javnson/GMP_SPM_Module/hw/PowerSupplyModule_DCSolution.pdf

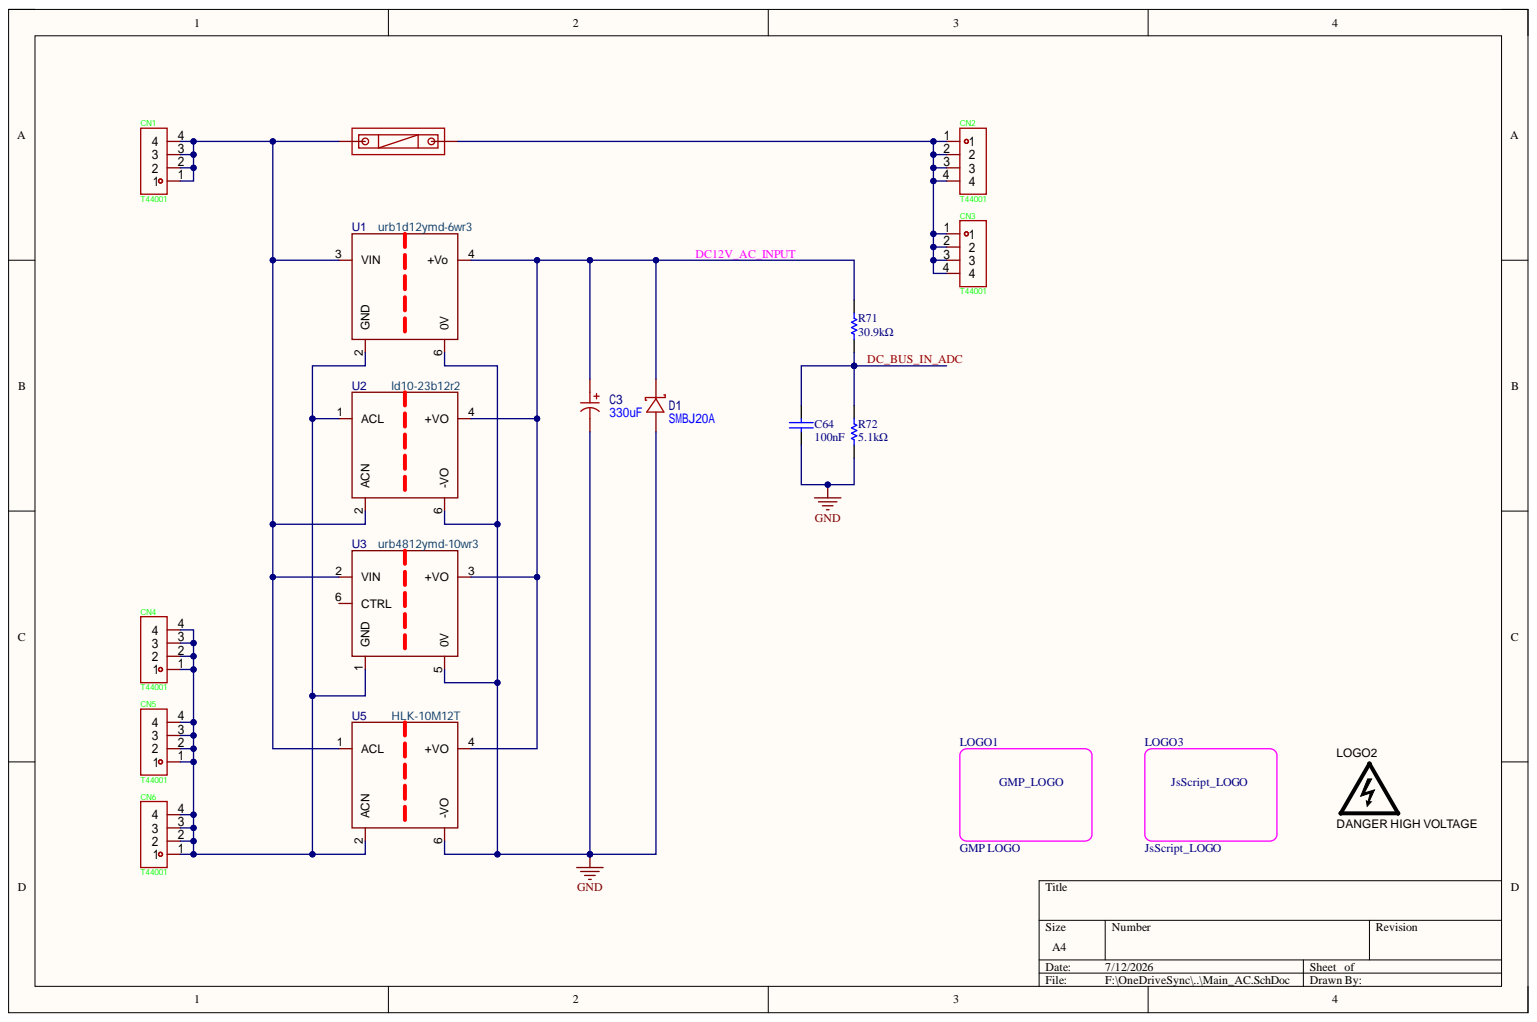
[picture p1: page 1]

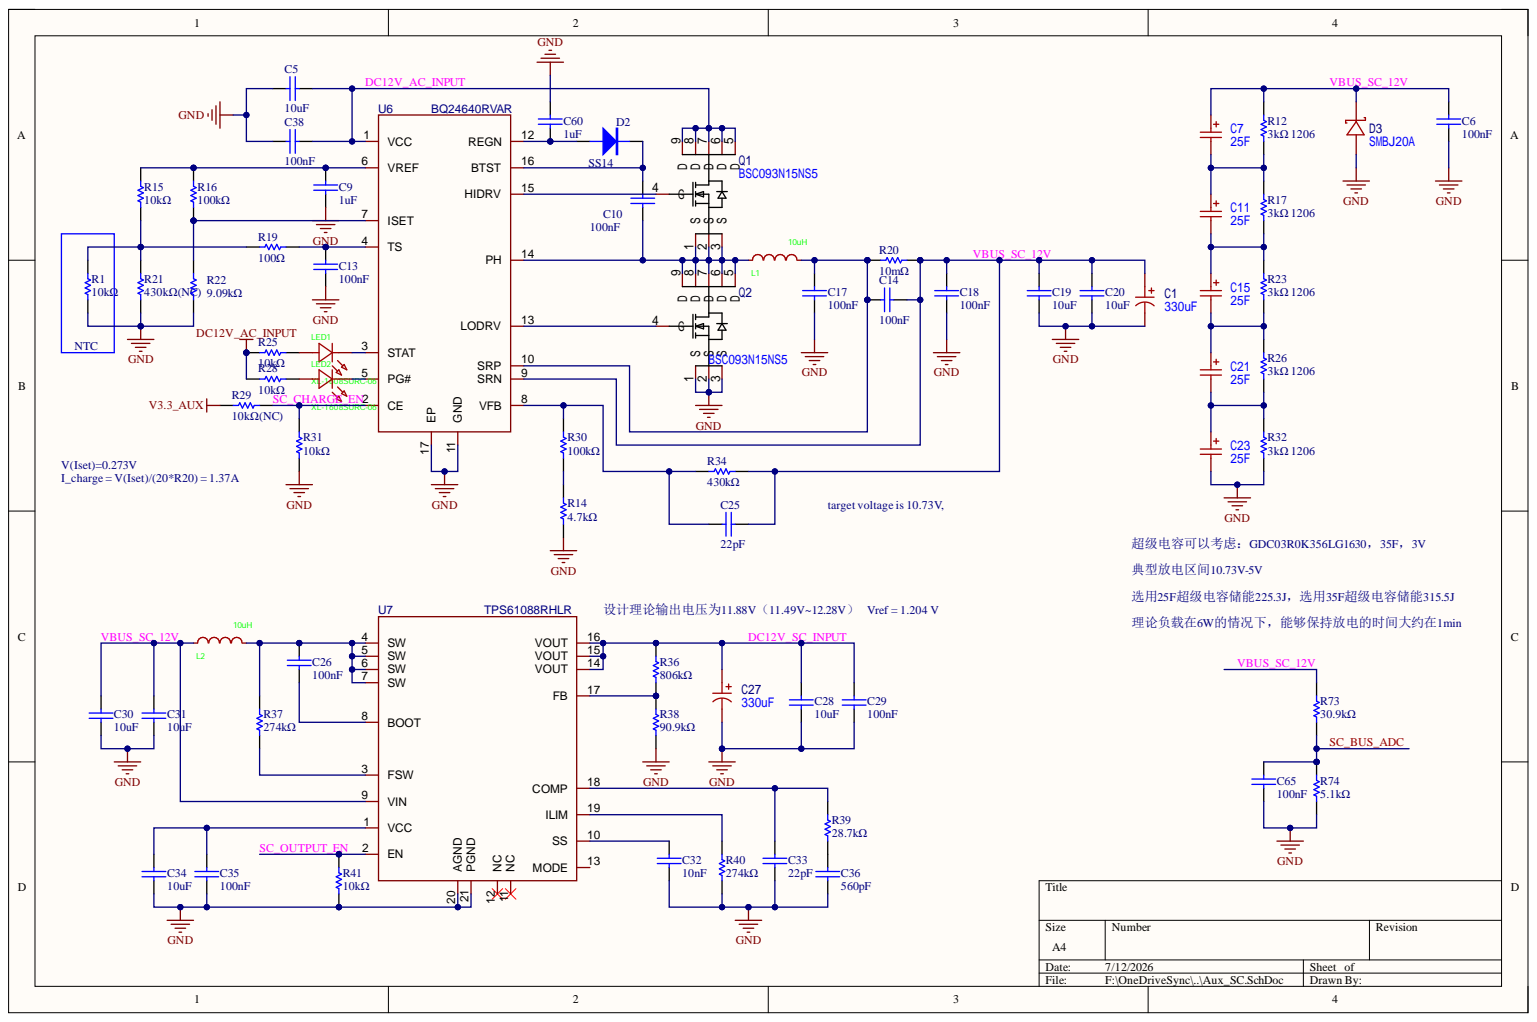
[picture p2: page 2]

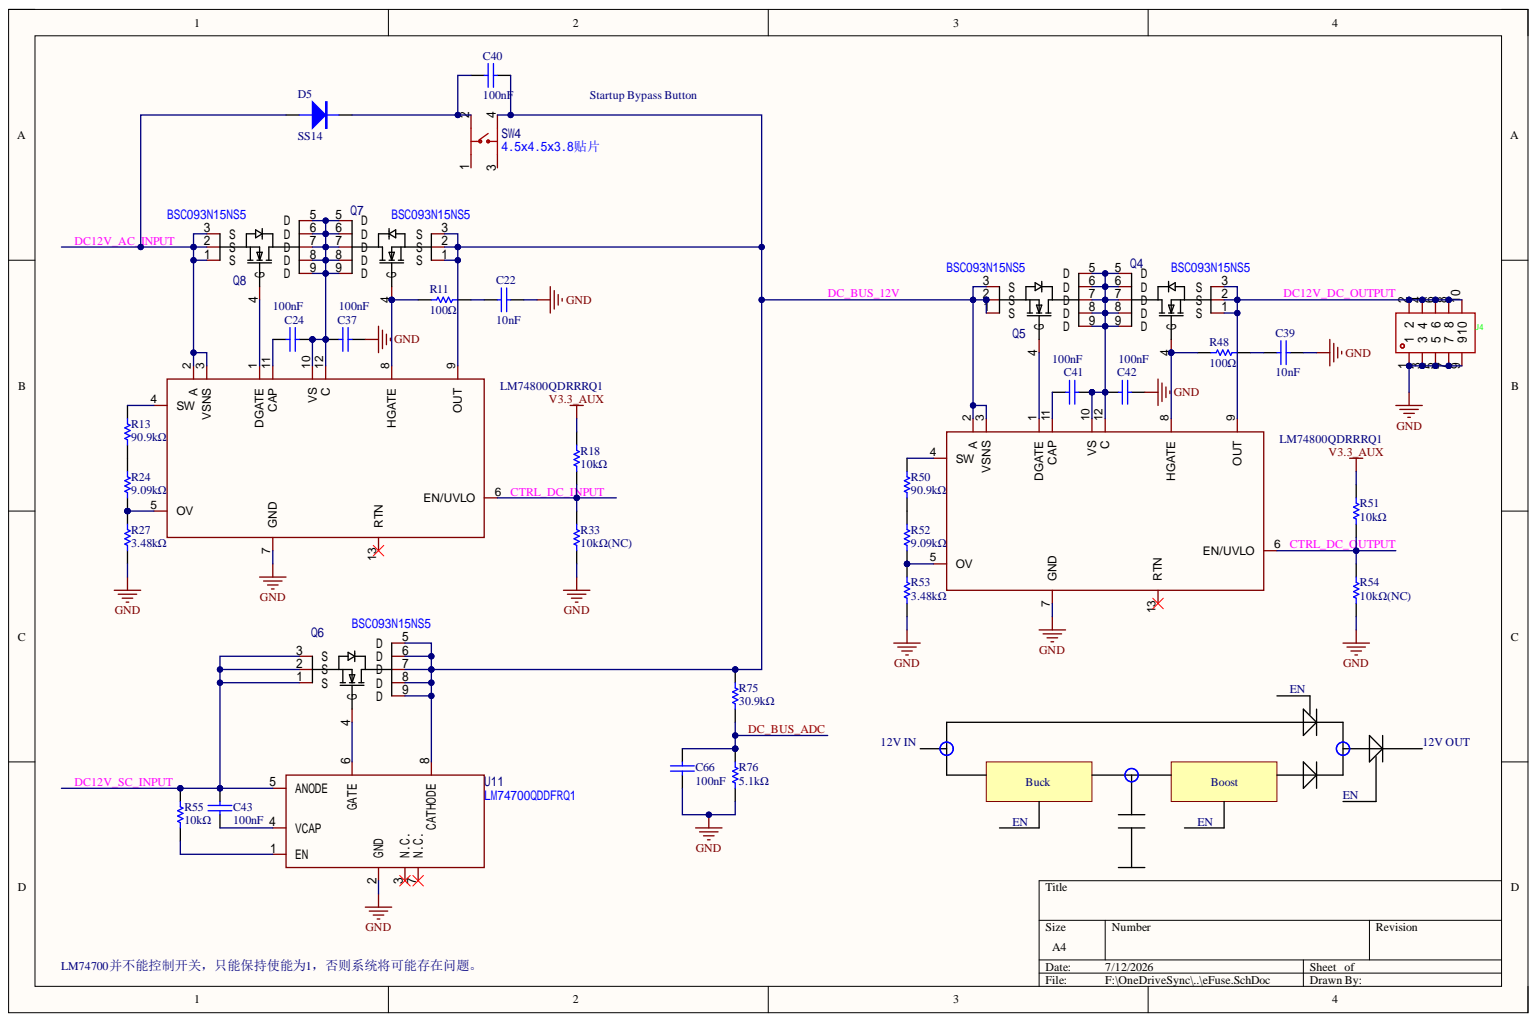
[picture p3: page 3]

GND | | Q5 | 100nF C41 | 100nF

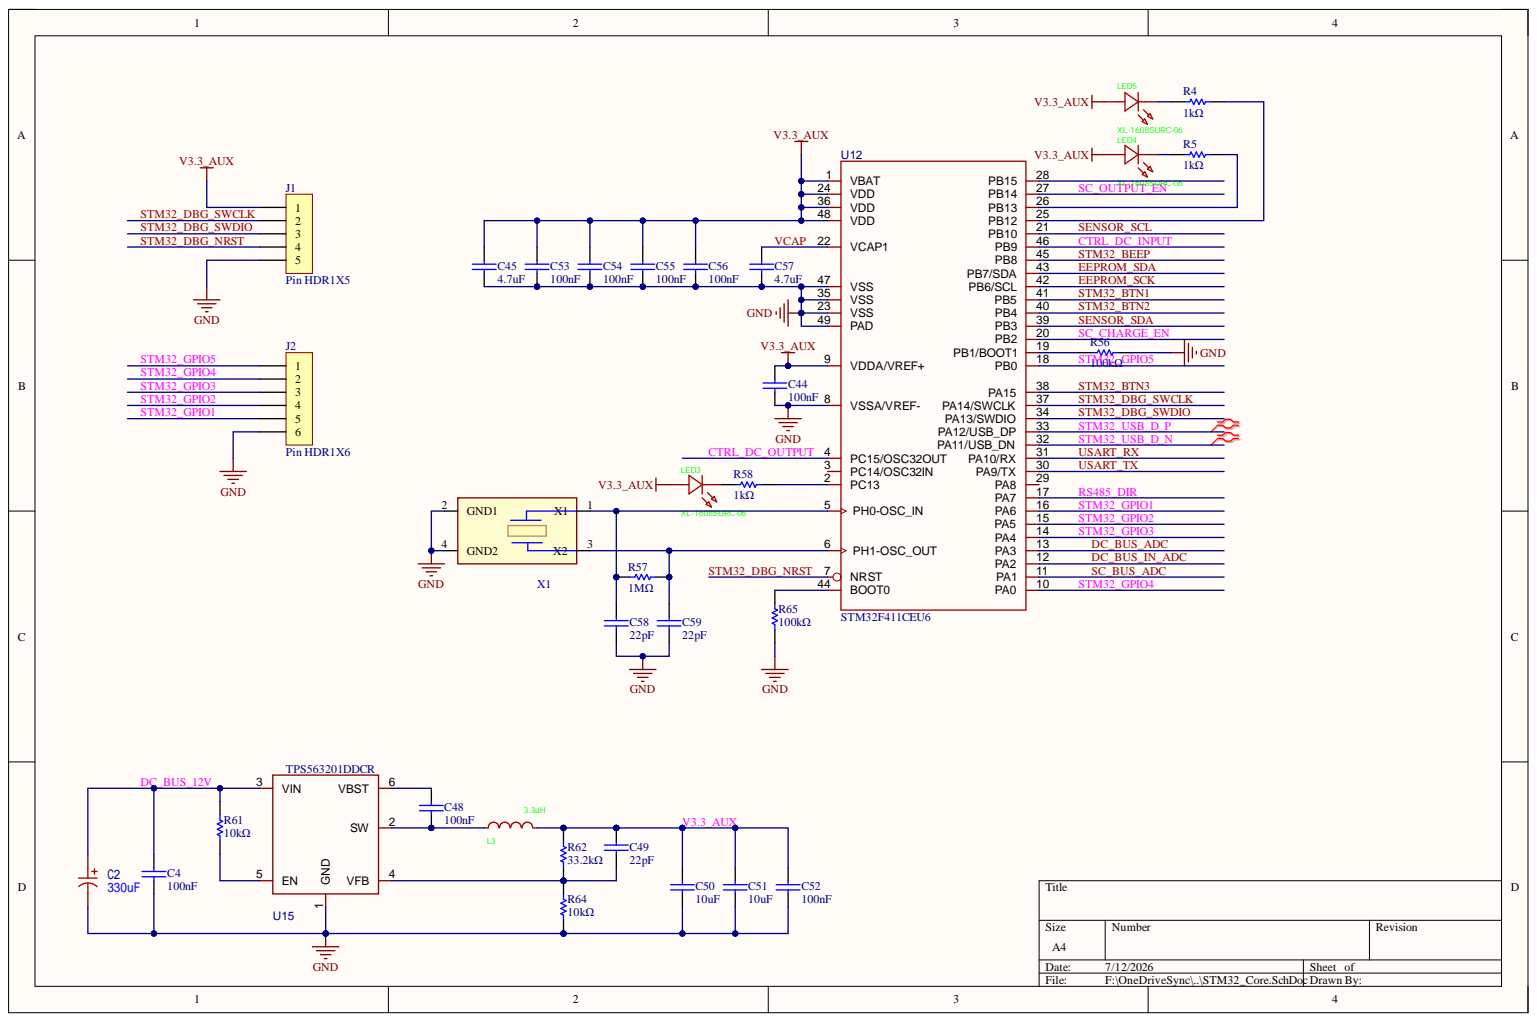
[picture p4: page 4]

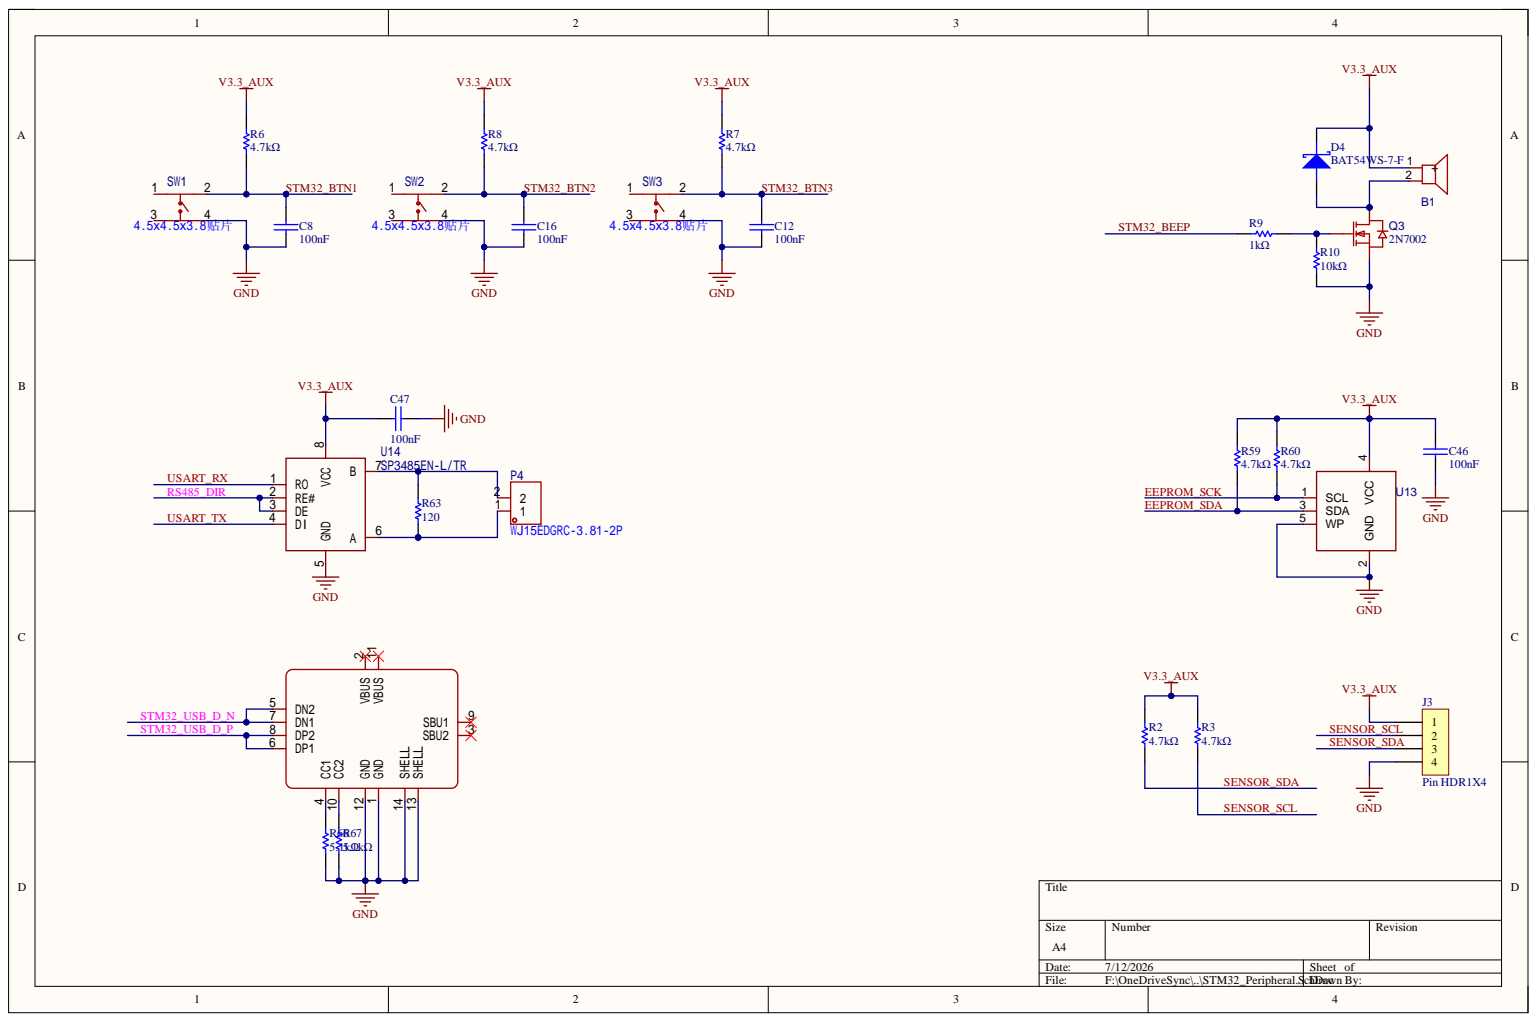
[picture p5: page 5]

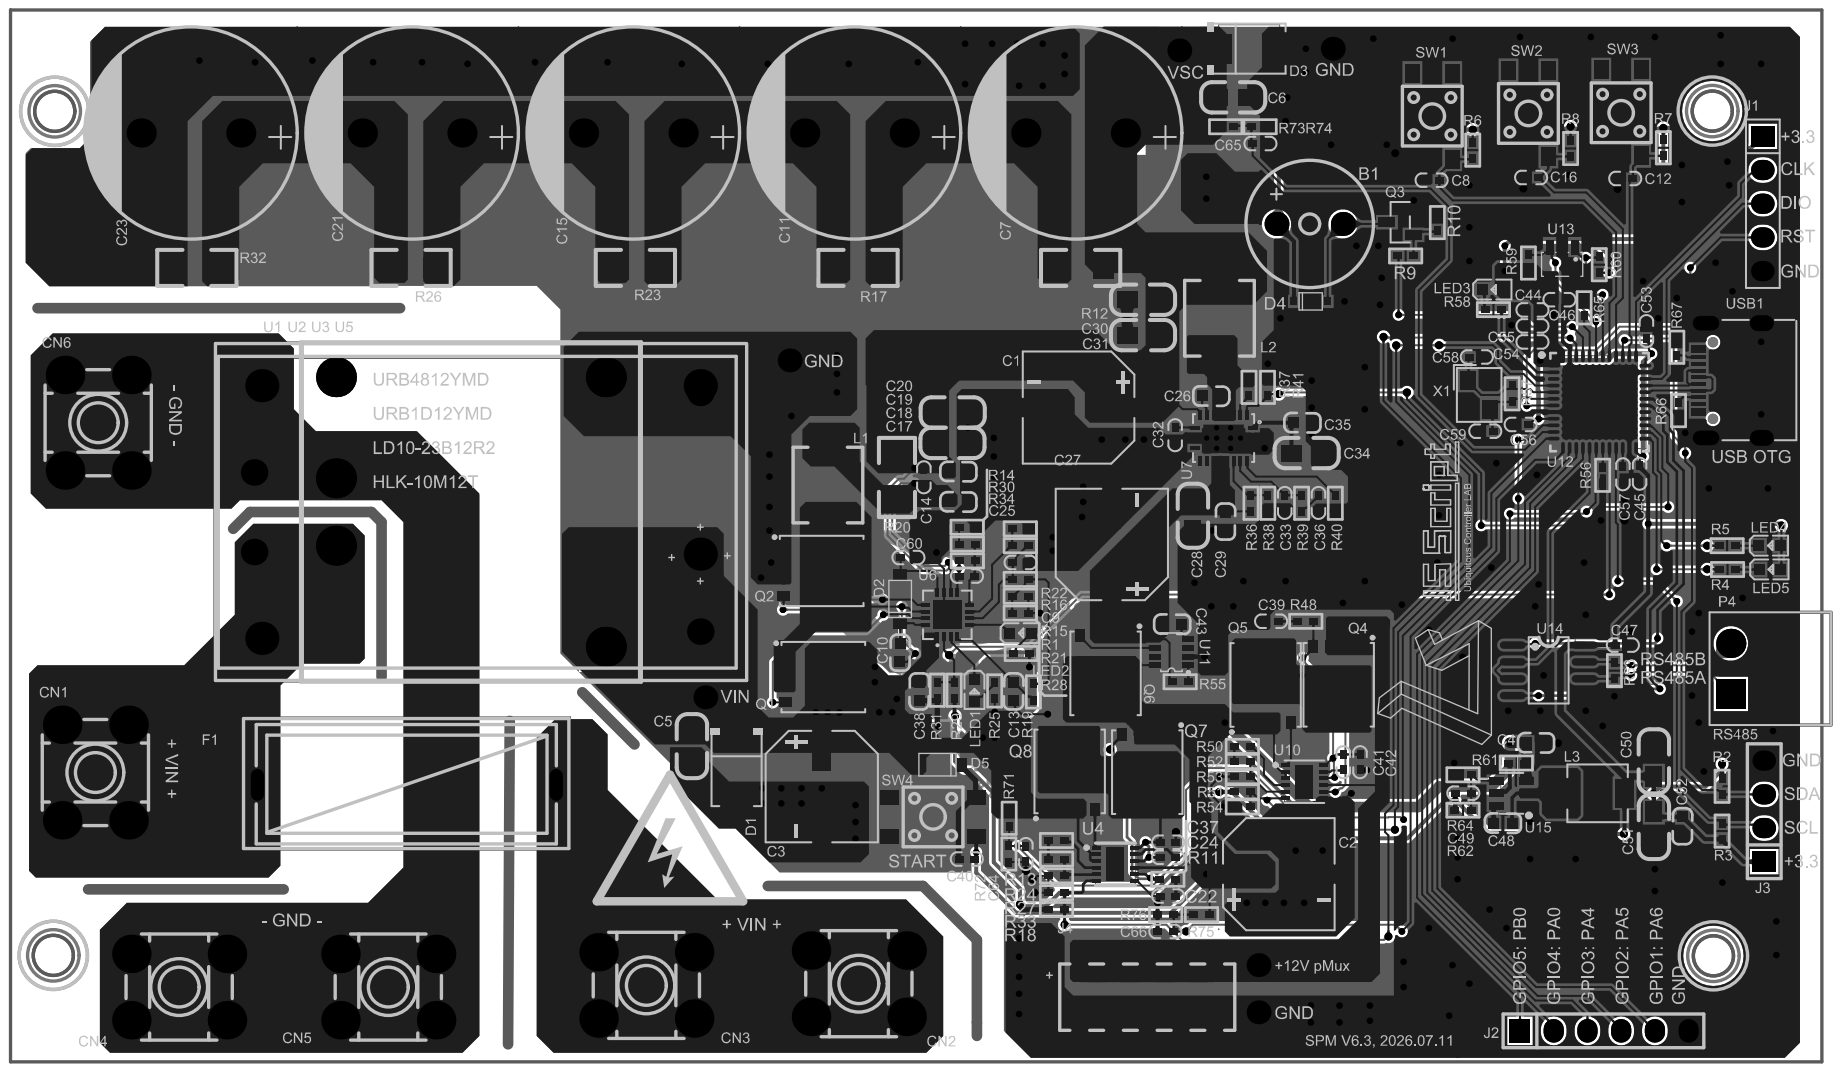
[picture p6: page 6]

Comment | Description | Designator | Footprint | LibRef | Quantity
HNB09A05 | Buzzer | B1 | BUZ-TH_BD9.6-
P5.00-D0.7-FD | HNB09A05 | 1
330uF | C970701 | C1, C2, C3, C27 | CAP-SMD_BD8.0-L8.3-W8.3-FD | RVT1E331M0810 330UF 25V | 4
100nF | 无极性电容 | C4, C10, C13, C17, C18, C26, C29, C35, C38, C43, C48, C52 | 0603C | CAP | 12
10uF | 无极性电容 | C5, C19, C20, C28, C30, C31, C34, C50, C51 | 0805C | CAP | 9
100nF | 无极性电容 | C6 | 0805C | CAP | 1
25F | BCT2R7M256YS162 5A2NP01 | C7, C11, C15, C21, C23 | CAP-TH_BD16.0-P7.50-D1.2-FD | ERF1VM222L25OT | 5
100nF | 无极性电容 | C8, C12, C14, C16, C24, C37, C40, C41, C42, C44, C46, C47, C53, C54, C55, C56, C64, C65, C66 | 0402C | CAP | 19
1uF | 无极性电容 | C9, C60 | 0402C | CAP | 2
10nF | 无极性电容 | C22, C32, C39 | 0402C | CAP | 3
22pF | 无极性电容 | C25, C33, C49, C58, C59 | 0402C | CAP | 5
560pF | 无极性电容 | C36 | 0402C | CAP | 1
4.7uF | 无极性电容 | C45, C57 | 0402C | CAP | 2
T44001 | | CN1, CN2, CN3, CN4, CN5, CN6 | CONN-TH_T44001 | T44001(PCB端子) | 6
SMBJ20A | C151257, [NoValue] | D1, D3 | SMB_L4.6-W3.6-LS5.3-RD | SMBJ20A_C151257 | 2
SS14 | 普通二极管 | D2, D5 | SOD-123 | DIODE | 2
BAT54WS-7-F | 肖特基二极管 | D4 | SOD-323 | DIODE SCHOTTKY | 1
保险丝透明座 | 保险丝座类型:支座 型;通道数:1;保险丝 类型:圆柱; | F1 | FUSE-TH_L24.5-W9.8-P22.5 | 保险丝透明座 | 1
Pin HDR1X5 | | J1 | Pin HDR1X5/2.54mm-S | Pin HDR1X5 | 1
Pin HDR1X6 | | J2 | Pin HDR1X6/2.54mm-S | Pin HDR1X6 | 1
Pin HDR1X4 | | J3 | Pin HDR1X4/2.54mm-S | Pin HDR1X4 | 1
PZ254-2-05-S | HDR-2.54-2*5P | J4 | HDR-SMD_10P-P2.54-V-M-R2-C5-LS7.5 | PZ254-2-05-S | 1
10uH | L | L1, L2 | IND-SMD_L5.7-W5.2_SMPI0520 | FXL0630-3R3-M | 2
3.3uH | L | L3 | IND-SMD_L4.4-W4.2 | FXL0630-3R3-M | 1
XL-1608SURC-06 | LED 0603 | LED1, LED2, LED3, LED4, LED5 | LED0603-RD_RED | XL-1608SURC-06 | 5
GMP LOGO | LOGO GMP Main. | LOGO1 | GMP LOGO | GMP_LOGO | 1
JsScript_LOGO | LOGO JsScript | LOGO3 | JsScript-R-V2-test-update | JsScript_LOGO | 1
WJ15EDGRC-3.81-2P | C8387 | P4 | CONN-TH_2P-P3.81_WJ15EDGRC-3.81-2P | WJ15EDGRC-3.81-2P | 1
BSC093N15NS5 | MOSFET Infineon 150V, 87A, 9.3mΩ @10V, 44A | Q1, Q2, Q4, Q5, Q6, Q7, Q8 | PG-TDSON-8_L5.0-W6.0-P1.27-LS6.2-BL-EP | BSC093N15NS5 | 7
2N7002 | MOSFET | Q3 | SOT-23-3_L2.9-W1.3-P1.90-LS2.4-BR | 2N7002 | 1
10kΩ | | R1, R10, R15, R18, R25, R28, R31, R41, R51, R55, R61, R64 | 0402R | RES | 12
4.7kΩ | | R2, R3, R6, R7, R8, R14, R59, R60 | 0402R | RES | 8
1kΩ | | R4, R5, R9, R58 | 0402R | RES | 4
100Ω | | R11, R19, R48 | 0402R | RES | 3
3kΩ 1206 | | R12, R17, R23, R26, R32 | 1206R | RES | 5
90.9kΩ | | R13, R38, R50 | 0402R | RES | 3
100kΩ | | R16, R30, R56, R65 | 0402R | RES | 4
10mΩ | | R20 | 1206R | RES | 1
430kΩ(NC) | | R21 | 0402R | RES | 1
9.09kΩ | | R22, R24, R52 | 0402R | RES | 3
3.48kΩ | | R27, R53 | 0402R | RES | 2
10kΩ(NC) | | R29, R33, R54 | 0402R | RES | 3
430kΩ | | R34 | 0402R | RES | 1
806kΩ | | R36 | 0402R | RES | 1
274kΩ | | R37, R40 | 0402R | RES | 2
28.7kΩ | | R39 | 0402R | RES | 1
1MΩ | | R57 | 0402R | RES | 1
33.2kΩ | | R62 | 0402R | RES | 1
120 | | R63 | 0402R | RES | 1
5.1kΩ | | R66, R67, R72, R74, R76 | 0402R | RES | 5
30.9kΩ | | R71, R73, R75 | 0402R | RES | 3
4.5x4.5x3.8贴片 | | SW1, SW2, SW3, SW4 | SW-SMD_4P-L4.5-W4.5-P3.00-LS6.8 | 4.5x4.5x3.8贴片 | 4
urb1d12ymd-6wr3 | 是隔离 6W DC-DC 转换器产品，输入 电压 40-160VDC， 效率高达 86%，输入 到输出隔离测试电 压为 2250VDC，可 在-40℃ 至 + 85℃ 的环境温度下安全 运行，具备输入欠 压保护、输出短路 、过流、过压保护 功能。 | U1 | PWRM-TH_URB1DXXYMD-6WR3 | urb1d12ymd-6wr3 | 1
ld10-23b12r2 | 超宽输入电压范 围，交直流两用， 低功耗，低纹波噪 声，高效率，高可 靠性，安全隔离。 广泛应用于工业、 电力、家电、仪表 、通讯及民用等行 业。 | U2 | PWRM-TH_LD10-23BXXR2 | ld10-23b12r2 | 1
urb4812ymd-10wr3 | URB4812YMD-10WR3系列产品输 出功率为10W,4:1超 宽电压输入范围， 效率高达91%， 1500VDC的常规隔 离电压允许工作温 度-40℃~+85℃， 具有输入欠压保 护，输出过压、过 流、 短路保护功 能，裸机满足 CISPR32/EN55032C LASSA,广泛应用于 医疗、工控、电力 、仪器仪表、通信 、铁路等领域。 | U3 | PWRM-TH_URBXXXXYMD-10WR3 | urb4812ymd-10wr3_c5369760 | 1
LM74800QDRRRQ1 | Ideal Diode | U4, U10 | WSON-12_L3.0-W3.0-P0.50-TL-EP-2 | LM74800QDRRRQ1 | 2
HLK-10M12T | 超宽输入电压范 围，交直流两用， 低功耗，低纹波噪 声，高效率，高可 靠性，安全隔离。 广泛应用于工业、 电力、家电、仪表 、通讯及民用等行 业。 | U5 | PWRM-TH_4P-L39.0-W23.5_HI-LINK_HLK-5MXXB | ld10-23b12r2 | 1
BQ24640RVAR | PWR SC Charger | U6 | VQFN-16_L3.6-W3.6-P0.50-BL-EP | BQ24640RVAR | 1
TPS61088RHLR | PWR Boost, 2.7V~12V -> 4.5V~12.6V, Im=10A | U7 | VQFN-20_L4.6-W3.6-P0.50-BL | TPS61088RHLR | 1
LM74700QDDFRQ1 | Ideal Diode Driver | U11 | TSOT-23-8_L2.9-W1.6-P0.65-LS2.8-BL | LM74700QDDFRQ1 | 1
STM32F411CEU6 | STM32 | U12 | UFQFPN-48_L7.0-W7.0-P0.50-BL-EP | STM32F411CEU6 | 1
AT24C08D-STUM-T-TUDI | Peripheral EEPROM 8kB | U13 | SOT-23-5_L3.0-W1.7-P0.95-LS2.8-BR | AT24C08D-STUM-T-TUDI | 1
SP3485EN-L/TR | | U14 | SOIC-8_L5.0-W4.0-P1.27-LS6.0-BL | SP3485EN-L/TR | 1
TPS563201DDCR | PWR Buck 4.5~17V -> 0.768~7V, 3A | U15 | SOT-23-6_L2.9-W1.6-P0.95-LS2.8-BL | TPS563201DDCR | 1
TYPE-C 16PIN 2MD(073) | USB Type C 12P | USB1 | USB-C-SMD_TYPE-C-6PIN-2MD-073 | TYPE-C 16PIN 2MD(073) | 1
OCS_25M_nopower | OSC passive, 3225 | X1 | CRYSTAL-SMD_4P-L3.2-W2.5-BL | OCS_25M_nopower | 1
