javnson/GMP_SPM_Module/STM32F411CEU6_SPM/STM32F411CEU6_SPM.ioc

Mcu.UserName=STM32F411CEUx
PA1.GPIO_Label=SC_BUS_ADC
PA1.Signal=ADCx_IN1
PA11.Signal=USB_OTG_FS_DM
PA12.Signal=USB_OTG_FS_DP
PA13.Signal=SYS_JTMS-SWDIO
PA14.Signal=SYS_JTCK-SWCLK
PA15.GPIO_Label=BTN3
PA15.Signal=GPIO_Input
PA2.GPIO_Label=DC_BUS_IN_ADC
PA2.Signal=ADCx_IN2
PA3.GPIO_Label=DC_BUS_ADC
PA3.Signal=ADCx_IN3
PA4.GPIO_Label=STATUS_FAULT
PA4.Signal=GPIO_Output
PA5.GPIO_Label=STATUS_SC_READY
PA5.Signal=GPIO_Output
PA6.GPIO_Label=STATUS_BACKUP
PA6.Signal=GPIO_Output
PA7.GPIO_Label=STATUS_INPUT
PA7.Signal=GPIO_Output
PB0.GPIO_Label=STATUS_OUTPUT
PB0.Signal=GPIO_Output
PB12.GPIO_Label=INPUT_LED
PB12.Signal=GPIO_Output
PB13.GPIO_Label=SC_LED
PB13.Signal=GPIO_Output
PB14.GPIO_Label=SC_OUTPUT_EN
PB14.Signal=GPIO_Output
PB2.GPIO_Label=SC_CHARGE_EN
PB2.Signal=GPIO_Output
PB4.GPIO_Label=BTN2
PB4.Signal=GPIO_Input
PB5.GPIO_Label=BTN1
PB5.Signal=GPIO_Input
PB6.Signal=I2C1_SCL
PB7.Signal=I2C1_SDA
PB8.GPIO_Label=BEEP
PB8.Signal=GPIO_Output
PB9.GPIO_Label=CTRL_DC_INPUT
PB9.Signal=GPIO_Output
PC13-ANTI_TAMP.GPIO_Label=SYS_LED
PC13-ANTI_TAMP.Signal=GPIO_Output
PC15-OSC32_OUT.GPIO_Label=CTRL_DC_OUTPUT
PC15-OSC32_OUT.Signal=GPIO_Output
