javnson/GMP_SPM_Module/STM32F411CEU6_SPM/Core/Src/power_control.c

#include "power_control.h"

#include "cmsis_os2.h"
#include "led_control.h"
#include "main.h"
#include "power_config.h"
#include "usbd_cdc_if.h"

#include <stdbool.h>
#include <stdio.h>
#include <string.h>

typedef enum
{
  POWER_MODE_STARTUP_CHARGE = 0,
  POWER_MODE_STARTUP_BOOST_SETTLE,
  POWER_MODE_NORMAL,
  POWER_MODE_BACKUP,
  POWER_MODE_MANUAL_TEST
} PowerMode;

enum
{
  POWER_FAULT_INPUT_LOST = (1UL << 0),
  POWER_FAULT_OUTPUT_LOW = (1UL << 1),
  POWER_FAULT_OUTPUT_HIGH = (1UL << 2),
  POWER_FAULT_SC_DEPLETED = (1UL << 3),
  POWER_FAULT_RAPID_DROP = (1UL << 4),
  POWER_FAULT_ADC = (1UL << 5)
};

typedef struct
{
  GPIO_TypeDef *port;
  uint16_t pin;
  GPIO_PinState raw;
  GPIO_PinState stable;
  uint32_t changed_at;
} Button;

typedef struct
{
  uint32_t magic;
  uint32_t version;
  uint32_t fault_count;
  uint32_t backup_count;
  uint32_t last_faults;
  uint32_t checksum;
} PersistentRecord;

typedef struct
{
  ADC_HandleTypeDef *hadc;
  I2C_HandleTypeDef *hi2c;
  uint32_t input_mv;
  uint32_t input_sample_mv;
  uint32_t bus_mv;
  uint32_t sc_mv;
  uint32_t sc_energy_percent;
  uint32_t faults;
  uint32_t previous_faults;
  uint32_t alarm_faults;
  uint32_t charge_full_since;
  uint32_t boost_settle_started_at;
  uint32_t rapid_drop_until;
  uint32_t telemetry_at;
  uint32_t input_invalid_since;
  uint32_t input_valid_since;
  uint32_t rapid_drop_reference_mv;
  uint32_t rapid_drop_reference_at;
  uint32_t buzzer_mode;
  bool input_valid;
  bool output_low;
  bool output_high;
  bool output_enabled;
  bool charge_requested;
  bool charge_enabled;
  bool boost_enabled;
  bool boost_forced_off;
  bool output_forced_off;
  bool startup_complete;
  bool alarm_muted;
  bool adc_failed;
  bool measurements_initialized;
  bool record_dirty;
  bool low_energy_warning;
  PowerMode mode;
  Button mute_button;
  Button test_button;
  Button charge_button;
  PersistentRecord record;
} PowerContext;

#define POWER_RECORD_MAGIC 0x53504D31UL
#define POWER_RECORD_VERSION 1UL

static PowerContext power;
volatile PowerDebugSnapshot g_power_debug;

static uint32_t RecordChecksum(const PersistentRecord *record)
{
  return record->magic ^ record->version ^ record->fault_count ^
         record->backup_count ^ record->last_faults ^ 0xA55A3CC3UL;
}

static void RecordLoad(void)
{
  PersistentRecord loaded;

  memset(&loaded, 0, sizeof(loaded));
  if (HAL_I2C_Mem_Read(power.hi2c, POWER_EEPROM_I2C_ADDRESS, 0U,
                       I2C_MEMADD_SIZE_8BIT, (uint8_t *)&loaded,
                       sizeof(loaded), POWER_EEPROM_TIMEOUT_MS) == HAL_OK &&
      loaded.magic == POWER_RECORD_MAGIC &&
      loaded.version == POWER_RECORD_VERSION &&
      loaded.checksum == RecordChecksum(&loaded))
  {
    power.record = loaded;
  }
  else
  {
    memset(&power.record, 0, sizeof(power.record));
    power.record.magic = POWER_RECORD_MAGIC;
    power.record.version = POWER_RECORD_VERSION;
    power.record.checksum = RecordChecksum(&power.record);
  }
}

static void RecordSave(void)
{
  uint8_t *bytes = (uint8_t *)&power.record;

  power.record.checksum = RecordChecksum(&power.record);
  (void)HAL_I2C_Mem_Write(power.hi2c, POWER_EEPROM_I2C_ADDRESS, 0U,
                          I2C_MEMADD_SIZE_8BIT, bytes, 16U,
                          POWER_EEPROM_TIMEOUT_MS);
  osDelay(POWER_EEPROM_WRITE_CYCLE_MS);
  (void)HAL_I2C_Mem_Write(power.hi2c, POWER_EEPROM_I2C_ADDRESS, 16U,
                          I2C_MEMADD_SIZE_8BIT, &bytes[16],
                          sizeof(power.record) - 16U, POWER_EEPROM_TIMEOUT_MS);
  osDelay(POWER_EEPROM_WRITE_CYCLE_MS);
  power.record_dirty = false;
}

static uint32_t ReadAdcMillivolts(uint32_t channel)
{
  ADC_ChannelConfTypeDef config = {0};
  uint32_t sum = 0U;
  uint32_t index;

  config.Channel = channel;
  config.Rank = 1U;
  config.SamplingTime = ADC_SAMPLETIME_84CYCLES;
  if (HAL_ADC_ConfigChannel(power.hadc, &config) != HAL_OK)
  {
    power.adc_failed = true;
    return 0U;
  }

  for (index = 0U; index < POWER_ADC_AVERAGE_SAMPLES; ++index)
  {
    if (HAL_ADC_Start(power.hadc) != HAL_OK ||
        HAL_ADC_PollForConversion(power.hadc, 2U) != HAL_OK)
    {
      (void)HAL_ADC_Stop(power.hadc);
      power.adc_failed = true;
      return 0U;
    }
    sum += HAL_ADC_GetValue(power.hadc);
    (void)HAL_ADC_Stop(power.hadc);
  }

  sum = (sum + (POWER_ADC_AVERAGE_SAMPLES / 2U)) / POWER_ADC_AVERAGE_SAMPLES;
  return (uint32_t)(((uint64_t)sum * POWER_ADC_REFERENCE_MV *
                    (POWER_ADC_DIVIDER_TOP_OHM + POWER_ADC_DIVIDER_BOTTOM_OHM)) /
                   ((uint64_t)POWER_ADC_FULL_SCALE * POWER_ADC_DIVIDER_BOTTOM_OHM));
}

static uint32_t FilterVoltage(uint32_t old_value, uint32_t new_value)
{
  return (old_value == 0U) ? new_value : ((old_value * 3U + new_value + 2U) / 4U);
}

static uint32_t SupercapEnergyPercent(uint32_t sc_mv)
{
  uint64_t voltage_squared;
  uint64_t cutoff_squared =
      (uint64_t)POWER_SC_BACKUP_CUTOFF_MV * POWER_SC_BACKUP_CUTOFF_MV;
  uint64_t full_squared =
      (uint64_t)POWER_SC_CHARGE_COMPLETE_MV * POWER_SC_CHARGE_COMPLETE_MV;

  if (sc_mv <= POWER_SC_BACKUP_CUTOFF_MV)
    return 0U;
  if (sc_mv >= POWER_SC_CHARGE_COMPLETE_MV)
    return 100U;

  voltage_squared = (uint64_t)sc_mv * sc_mv;
  return (uint32_t)(((voltage_squared - cutoff_squared) * 100U) /
                    (full_squared - cutoff_squared));
}

static bool ButtonPressed(Button *button, uint32_t now)
{
  GPIO_PinState sample = HAL_GPIO_ReadPin(button->port, button->pin);

  if (sample != button->raw)
  {
    button->raw = sample;
    button->changed_at = now;
  }
  if (sample != button->stable && (now - button->changed_at) >= POWER_BUTTON_DEBOUNCE_MS)
  {
    button->stable = sample;
    return sample == GPIO_PIN_RESET;
  }
  return false;
}

static void UpdateMeasurements(uint32_t now)
{
  uint32_t bus_sample;
  uint32_t sc_sample;

  power.adc_failed = false;
  sc_sample = ReadAdcMillivolts(ADC_CHANNEL_1);
  power.input_sample_mv = ReadAdcMillivolts(ADC_CHANNEL_2);
  bus_sample = ReadAdcMillivolts(ADC_CHANNEL_3);
  if (!power.adc_failed)
  {
    if (!power.measurements_initialized)
    {
      power.sc_mv = sc_sample;
      power.input_mv = power.input_sample_mv;
      power.bus_mv = bus_sample;
      power.input_valid = power.input_sample_mv >= POWER_INPUT_UV_RECOVER_MV;
      power.measurements_initialized = true;
    }
    else
    {
      power.sc_mv = FilterVoltage(power.sc_mv, sc_sample);
      power.input_mv = FilterVoltage(power.input_mv, power.input_sample_mv);
      power.bus_mv = FilterVoltage(power.bus_mv, bus_sample);
    }
    power.sc_energy_percent = SupercapEnergyPercent(power.sc_mv);
  }

  /* An emergency raw threshold bypasses the normal debounce so BOOST can take
   * over quickly if the source disappears while the charger is active. */
  if (power.input_sample_mv < POWER_INPUT_EMERGENCY_TRIP_MV)
  {
    power.input_valid = false;
    power.input_invalid_since = 0U;
    power.input_valid_since = 0U;
  }
  else if (power.input_valid)
  {
    if (power.input_mv < POWER_INPUT_UV_TRIP_MV)
    {
      if (power.input_invalid_since == 0U)
        power.input_invalid_since = now;
      if ((now - power.input_invalid_since) >= POWER_INPUT_DEBOUNCE_MS)
        power.input_valid = false;
    }
    else
    {
      power.input_invalid_since = 0U;
    }
  }
  else
  {
    if (power.input_mv >= POWER_INPUT_UV_RECOVER_MV)
    {
      if (power.input_valid_since == 0U)
        power.input_valid_since = now;
      if ((now - power.input_valid_since) >= POWER_INPUT_DEBOUNCE_MS)
        power.input_valid = true;
    }
    else
    {
      power.input_valid_since = 0U;
    }
  }

  if (!power.output_low && power.bus_mv < POWER_OUTPUT_UV_TRIP_MV)
    power.output_low = true;
  else if (power.output_low && power.bus_mv >= POWER_OUTPUT_UV_RECOVER_MV)
    power.output_low = false;

  if (!power.output_high && power.bus_mv > POWER_OUTPUT_OV_TRIP_MV)
    power.output_high = true;
  else if (power.output_high && power.bus_mv <= POWER_OUTPUT_OV_RECOVER_MV)
    power.output_high = false;

  if ((now - power.rapid_drop_reference_at) >= POWER_RAPID_DROP_WINDOW_MS)
  {
    if (power.rapid_drop_reference_mv > power.bus_mv &&
        (power.rapid_drop_reference_mv - power.bus_mv) >= POWER_RAPID_DROP_MV)
      power.rapid_drop_until = now + POWER_RAPID_DROP_HOLD_MS;
    power.rapid_drop_reference_mv = power.bus_mv;
    power.rapid_drop_reference_at = now;
  }
}

static void EnterBackup(void)
{
  if (power.mode != POWER_MODE_BACKUP)
  {
    power.mode = POWER_MODE_BACKUP;
    ++power.record.backup_count;
    power.record_dirty = true;
  }
}

static bool UpdateChargeCompletion(uint32_t now)
{
  if (!power.charge_requested)
  {
    power.charge_full_since = 0U;
    return false;
  }

  if (power.sc_mv >= POWER_SC_CHARGE_COMPLETE_MV)
  {
    if (power.charge_full_since == 0U)
      power.charge_full_since = now;
    else if ((now - power.charge_full_since) >= POWER_SC_CHARGE_HOLD_MS)
    {
      power.charge_requested = false;
      power.charge_full_since = 0U;
      return true;
    }
  }
  else
  {
    /* The 5 s confirmation must be continuous at or above 10.5 V. */
    power.charge_full_since = 0U;
  }
  return false;
}

static void HandleButtons(uint32_t now, bool mute_pressed, bool test_pressed,
                          bool charge_pressed, bool *manual_test_request)
{
  bool modifier_held = power.mute_button.stable == GPIO_PIN_RESET;

  (void)now;
  *manual_test_request = false;

  if (test_pressed && modifier_held)
  {
    power.boost_forced_off = !power.boost_forced_off;
    if (power.boost_forced_off && power.mode == POWER_MODE_MANUAL_TEST)
      power.mode = power.input_valid ? POWER_MODE_NORMAL : POWER_MODE_BACKUP;
  }
  else if (test_pressed)
  {
    *manual_test_request = true;
  }

  if (charge_pressed && modifier_held)
  {
    power.output_forced_off = !power.output_forced_off;
  }
  else if (charge_pressed &&
           (power.mode == POWER_MODE_STARTUP_CHARGE ||
            power.mode == POWER_MODE_NORMAL))
  {
    power.charge_requested = !power.charge_requested;
    power.charge_full_since = 0U;
  }

  if (mute_pressed &&
      (power.alarm_faults != 0U || power.low_energy_warning))
    power.alarm_muted = true;
}

static void UpdateMode(uint32_t now, bool charge_complete, bool manual_test_request)
{
  switch (power.mode)
  {
    case POWER_MODE_STARTUP_CHARGE:
      if (charge_complete)
      {
        power.mode = POWER_MODE_STARTUP_BOOST_SETTLE;
        power.boost_settle_started_at = now;
      }
      break;

    case POWER_MODE_STARTUP_BOOST_SETTLE:
      if ((now - power.boost_settle_started_at) >= POWER_BOOST_SETTLE_MS)
      {
        power.startup_complete = true;
        if (power.input_valid)
          power.mode = POWER_MODE_NORMAL;
        else
          EnterBackup();
      }
      break;

    case POWER_MODE_NORMAL:
      if (!power.input_valid)
      {
        EnterBackup();
      }
      else if (manual_test_request && !power.boost_forced_off &&
               power.sc_mv >= POWER_SC_MANUAL_TEST_STOP_MV)
      {
        power.mode = POWER_MODE_MANUAL_TEST;
      }
      break;

    case POWER_MODE_BACKUP:
      if (power.input_valid)
        power.mode = POWER_MODE_NORMAL;
      break;

    case POWER_MODE_MANUAL_TEST:
      if (!power.input_valid)
      {
        EnterBackup();
      }
      else if (manual_test_request || power.boost_forced_off ||
               power.sc_mv < POWER_SC_MANUAL_TEST_STOP_MV)
      {
        power.mode = POWER_MODE_NORMAL;
      }
      break;

    default:
      power.mode = POWER_MODE_STARTUP_CHARGE;
      break;
  }
}

static void ApplyPowerPath(void)
{
  bool allow_charge;
  bool desired_boost;
  bool main_input_enabled;

  main_input_enabled = power.mode != POWER_MODE_BACKUP &&
                       power.mode != POWER_MODE_MANUAL_TEST;
  HAL_GPIO_WritePin(CTRL_DC_INPUT_GPIO_Port, CTRL_DC_INPUT_Pin,
                    main_input_enabled ? GPIO_PIN_SET : GPIO_PIN_RESET);

  allow_charge = power.mode == POWER_MODE_STARTUP_CHARGE ||
                 power.mode == POWER_MODE_NORMAL;
  power.charge_enabled = power.charge_requested && power.input_valid && allow_charge;

  desired_boost = !power.charge_enabled && !power.boost_forced_off;
  if ((power.mode == POWER_MODE_BACKUP || power.mode == POWER_MODE_MANUAL_TEST) &&
      power.sc_mv < POWER_SC_BACKUP_CUTOFF_MV)
    desired_boost = false;

  /* Always turn one converter off before enabling the other. This guarantees
   * that charger and BOOST can never be active together. */
  if (power.charge_enabled)
  {
    HAL_GPIO_WritePin(SC_OUTPUT_EN_GPIO_Port, SC_OUTPUT_EN_Pin, GPIO_PIN_RESET);
    power.boost_enabled = false;
    HAL_GPIO_WritePin(SC_CHARGE_EN_GPIO_Port, SC_CHARGE_EN_Pin, GPIO_PIN_SET);
  }
  else
  {
    HAL_GPIO_WritePin(SC_CHARGE_EN_GPIO_Port, SC_CHARGE_EN_Pin, GPIO_PIN_RESET);
    HAL_GPIO_WritePin(SC_OUTPUT_EN_GPIO_Port, SC_OUTPUT_EN_Pin,
                      desired_boost ? GPIO_PIN_SET : GPIO_PIN_RESET);
    power.boost_enabled = desired_boost;
  }
}

static void UpdateOutputEnable(void)
{
  if (!power.startup_complete || power.output_forced_off)
  {
    power.output_enabled = false;
  }
  else if (!power.output_enabled && power.bus_mv >= POWER_OUTPUT_ENABLE_MV &&
           !power.output_high)
  {
    power.output_enabled = true;
  }
  else if (power.output_enabled && power.bus_mv < POWER_OUTPUT_DISABLE_MV)
  {
    power.output_enabled = false;
  }

  HAL_GPIO_WritePin(CTRL_DC_OUTPUT_GPIO_Port, CTRL_DC_OUTPUT_Pin,
                    power.output_enabled ? GPIO_PIN_SET : GPIO_PIN_RESET);
}

static void UpdateFaults(uint32_t now)
{
  uint32_t alarm_faults;

  power.faults = 0U;
  if (now >= POWER_STARTUP_GRACE_MS)
  {
    if (!power.input_valid)
      power.faults |= POWER_FAULT_INPUT_LOST;
    if (power.output_low)
      power.faults |= POWER_FAULT_OUTPUT_LOW;
    if (power.output_high)
      power.faults |= POWER_FAULT_OUTPUT_HIGH;
    if ((power.mode == POWER_MODE_BACKUP || power.mode == POWER_MODE_MANUAL_TEST) &&
        power.sc_mv < POWER_SC_BACKUP_CUTOFF_MV)
      power.faults |= POWER_FAULT_SC_DEPLETED;
    if ((int32_t)(power.rapid_drop_until - now) > 0)
      power.faults |= POWER_FAULT_RAPID_DROP;
    if (power.adc_failed)
      power.faults |= POWER_FAULT_ADC;
  }

  alarm_faults = power.faults & (POWER_FAULT_INPUT_LOST | POWER_FAULT_OUTPUT_LOW |
                                  POWER_FAULT_OUTPUT_HIGH);
  if ((alarm_faults & ~power.alarm_faults) != 0U)
    power.alarm_muted = false;
  if (alarm_faults == 0U && !power.low_energy_warning)
    power.alarm_muted = false;
  power.alarm_faults = alarm_faults;

  if (power.faults != 0U && power.previous_faults == 0U)
  {
    ++power.record.fault_count;
    power.record.last_faults = power.faults;
    power.record_dirty = true;
  }
  power.previous_faults = power.faults;
}

static void UpdateBuzzer(uint32_t now)
{
  uint32_t phase;
  uint32_t pulse_slot;
  uint32_t pulse_train_ms;
  bool low_energy_warning;
  bool beep_on = false;

  low_energy_warning =
      power.output_enabled &&
      (power.mode == POWER_MODE_BACKUP ||
       power.mode == POWER_MODE_MANUAL_TEST) &&
      power.sc_energy_percent <= POWER_SC_LOW_ENERGY_WARNING_PERCENT;

  if (low_energy_warning && !power.low_energy_warning)
    power.alarm_muted = false;
  power.low_energy_warning = low_energy_warning;

  if (!power.output_enabled)
  {
    power.buzzer_mode = 0U;
  }
  else if (low_energy_warning)
  {
    power.buzzer_mode = 2U;
    if (!power.alarm_muted)
    {
      phase = now % POWER_LOW_ENERGY_BEEP_PERIOD_MS;
      pulse_slot = POWER_LOW_ENERGY_BEEP_ON_MS +
                   POWER_LOW_ENERGY_BEEP_GAP_MS;
      pulse_train_ms = pulse_slot * POWER_LOW_ENERGY_BEEP_COUNT;
      if (phase < pulse_train_ms &&
          (phase % pulse_slot) < POWER_LOW_ENERGY_BEEP_ON_MS)
        beep_on = true;
    }
  }
  else if (power.alarm_faults != 0U && !power.alarm_muted)
  {
    power.buzzer_mode = 1U;
    beep_on = true;
  }
  else
  {
    power.buzzer_mode = 0U;
  }

  HAL_GPIO_WritePin(BEEP_GPIO_Port, BEEP_Pin,
                    beep_on ? GPIO_PIN_SET : GPIO_PIN_RESET);
}

static void UpdateIndicators(void)
{
  LedControl_SetSystem(power.faults != 0U);
  LedControl_SetLed5(power.input_valid, power.charge_enabled,
                    power.mode == POWER_MODE_MANUAL_TEST);
  LedControl_SetSupercapEnergy(power.sc_energy_percent);

  HAL_GPIO_WritePin(STATUS_INPUT_GPIO_Port, STATUS_INPUT_Pin,
                    power.input_valid ? GPIO_PIN_SET : GPIO_PIN_RESET);
  HAL_GPIO_WritePin(STATUS_SC_READY_GPIO_Port, STATUS_SC_READY_Pin,
                    power.sc_mv >= POWER_SC_MANUAL_TEST_STOP_MV ?
                    GPIO_PIN_SET : GPIO_PIN_RESET);
  HAL_GPIO_WritePin(STATUS_BACKUP_GPIO_Port, STATUS_BACKUP_Pin,
                    (power.mode == POWER_MODE_BACKUP ||
                     power.mode == POWER_MODE_MANUAL_TEST) ?
                    GPIO_PIN_SET : GPIO_PIN_RESET);
  HAL_GPIO_WritePin(STATUS_FAULT_GPIO_Port, STATUS_FAULT_Pin,
                    power.faults != 0U ? GPIO_PIN_SET : GPIO_PIN_RESET);
  HAL_GPIO_WritePin(STATUS_OUTPUT_GPIO_Port, STATUS_OUTPUT_Pin,
                    (power.output_enabled && !power.output_low && !power.output_high) ?
                    GPIO_PIN_SET : GPIO_PIN_RESET);
}

static const char *ModeName(PowerMode mode)
{
  switch (mode)
  {
    case POWER_MODE_STARTUP_CHARGE: return "STARTUP_CHARGE";
    case POWER_MODE_STARTUP_BOOST_SETTLE: return "STARTUP_BOOST";
    case POWER_MODE_NORMAL: return "NORMAL";
    case POWER_MODE_BACKUP: return "BACKUP";
    case POWER_MODE_MANUAL_TEST: return "MANUAL_TEST";
    default: return "UNKNOWN";
  }
}

static void UpdateDebugSnapshot(void)
{
  g_power_debug.input_mv = power.input_mv;
  g_power_debug.bus_mv = power.bus_mv;
  g_power_debug.sc_mv = power.sc_mv;
  g_power_debug.sc_energy_percent = power.sc_energy_percent;
  g_power_debug.faults = power.faults;
  g_power_debug.mode = (uint32_t)power.mode;
  g_power_debug.input_valid = power.input_valid ? 1U : 0U;
  g_power_debug.boost_enabled = power.boost_enabled ? 1U : 0U;
  g_power_debug.charge_requested = power.charge_requested ? 1U : 0U;
  g_power_debug.charge_enabled = power.charge_enabled ? 1U : 0U;
  g_power_debug.output_enabled = power.output_enabled ? 1U : 0U;
  g_power_debug.boost_forced_off = power.boost_forced_off ? 1U : 0U;
  g_power_debug.output_forced_off = power.output_forced_off ? 1U : 0U;
  g_power_debug.startup_complete = power.startup_complete ? 1U : 0U;
  g_power_debug.alarm_muted = power.alarm_muted ? 1U : 0U;
  g_power_debug.low_energy_warning = power.low_energy_warning ? 1U : 0U;
  g_power_debug.buzzer_mode = power.buzzer_mode;
}

static void PrintTelemetry(uint32_t now)
{
  char line[320];
  int length;

  if ((now - power.telemetry_at) < POWER_TELEMETRY_PERIOD_MS)
    return;
  power.telemetry_at = now;
  length = snprintf(line, sizeof(line),
                    "SPM input=%lu.%03luV bus=%lu.%03luV sc=%lu.%03luV energy=%lu%% mode=%s "
                    "boost=%u charge_req=%u charge=%u output=%u force_boost_off=%u force_output_off=%u "
                    "faults=0x%02lX buzzer=%lu muted=%u counts=%lu/%lu\r\n",
                    (unsigned long)(power.input_mv / 1000U),
                    (unsigned long)(power.input_mv % 1000U),
                    (unsigned long)(power.bus_mv / 1000U),
                    (unsigned long)(power.bus_mv % 1000U),
                    (unsigned long)(power.sc_mv / 1000U),
                    (unsigned long)(power.sc_mv % 1000U),
                    (unsigned long)power.sc_energy_percent,
                    ModeName(power.mode), power.boost_enabled ? 1U : 0U,
                    power.charge_requested ? 1U : 0U,
                    power.charge_enabled ? 1U : 0U,
                    power.output_enabled ? 1U : 0U,
                    power.boost_forced_off ? 1U : 0U,
                    power.output_forced_off ? 1U : 0U,
                    (unsigned long)power.faults,
                    (unsigned long)power.buzzer_mode,
                    power.alarm_muted ? 1U : 0U,
                    (unsigned long)power.record.fault_count,
                    (unsigned long)power.record.backup_count);
  if (length > 0)
  {
    if ((size_t)length >= sizeof(line))
      length = (int)sizeof(line) - 1;
    (void)CDC_Transmit_FS((uint8_t *)line, (uint16_t)length);
  }
}

void PowerControl_Init(ADC_HandleTypeDef *hadc, I2C_HandleTypeDef *hi2c,
                       TIM_HandleTypeDef *htim_led)
{
  uint32_t now = osKernelGetTickCount();

  memset(&power, 0, sizeof(power));
  memset((void *)&g_power_debug, 0, sizeof(g_power_debug));
  power.hadc = hadc;
  power.hi2c = hi2c;
  power.mode = POWER_MODE_STARTUP_CHARGE;
  power.charge_requested = true;
  power.mute_button = (Button){BTN1_GPIO_Port, BTN1_Pin,
                               GPIO_PIN_SET, GPIO_PIN_SET, now};
  power.test_button = (Button){BTN2_GPIO_Port, BTN2_Pin,
                               GPIO_PIN_SET, GPIO_PIN_SET, now};
  power.charge_button = (Button){BTN3_GPIO_Port, BTN3_Pin,
                                 GPIO_PIN_SET, GPIO_PIN_SET, now};

  HAL_GPIO_WritePin(CTRL_DC_INPUT_GPIO_Port, CTRL_DC_INPUT_Pin, GPIO_PIN_SET);
  HAL_GPIO_WritePin(CTRL_DC_OUTPUT_GPIO_Port, CTRL_DC_OUTPUT_Pin, GPIO_PIN_RESET);
  HAL_GPIO_WritePin(SC_CHARGE_EN_GPIO_Port, SC_CHARGE_EN_Pin, GPIO_PIN_RESET);
  HAL_GPIO_WritePin(SC_OUTPUT_EN_GPIO_Port, SC_OUTPUT_EN_Pin, GPIO_PIN_RESET);
  HAL_GPIO_WritePin(BEEP_GPIO_Port, BEEP_Pin, GPIO_PIN_RESET);
  LedControl_Init(htim_led);
  RecordLoad();
  UpdateDebugSnapshot();
}

void PowerControl_Run(void)
{
  uint32_t now = osKernelGetTickCount();
  bool mute_pressed;
  bool test_pressed;
  bool charge_pressed;
  bool manual_test_request;
  bool charge_complete;

  UpdateMeasurements(now);
  mute_pressed = ButtonPressed(&power.mute_button, now);
  test_pressed = ButtonPressed(&power.test_button, now);
  charge_pressed = ButtonPressed(&power.charge_button, now);
  HandleButtons(now, mute_pressed, test_pressed, charge_pressed,
                &manual_test_request);
  charge_complete = UpdateChargeCompletion(now);
  UpdateMode(now, charge_complete, manual_test_request);
  ApplyPowerPath();
  UpdateOutputEnable();
  UpdateFaults(now);
  UpdateBuzzer(now);
  UpdateIndicators();
  UpdateDebugSnapshot();
  PrintTelemetry(now);

  /* EEPROM writes are deliberately last: a slow or absent EEPROM must never
   * delay BOOST activation or a load-disconnect safety action. */
  if (power.record_dirty)
    RecordSave();
}
