javnson/GMP_SPM_Module/STM32F411CEU6_SPM/Core/Inc/main.h

#define SYS_LED_Pin GPIO_PIN_13
#define SYS_LED_GPIO_Port GPIOC
#define CTRL_DC_OUTPUT_Pin GPIO_PIN_15
#define CTRL_DC_OUTPUT_GPIO_Port GPIOC
#define SC_BUS_ADC_Pin GPIO_PIN_1
#define SC_BUS_ADC_GPIO_Port GPIOA
#define DC_BUS_IN_ADC_Pin GPIO_PIN_2
#define DC_BUS_IN_ADC_GPIO_Port GPIOA
#define DC_BUS_ADC_Pin GPIO_PIN_3
#define DC_BUS_ADC_GPIO_Port GPIOA
#define STATUS_FAULT_Pin GPIO_PIN_4
#define STATUS_FAULT_GPIO_Port GPIOA
#define STATUS_SC_READY_Pin GPIO_PIN_5
#define STATUS_SC_READY_GPIO_Port GPIOA
#define STATUS_BACKUP_Pin GPIO_PIN_6
#define STATUS_BACKUP_GPIO_Port GPIOA
#define STATUS_INPUT_Pin GPIO_PIN_7
#define STATUS_INPUT_GPIO_Port GPIOA
#define STATUS_OUTPUT_Pin GPIO_PIN_0
#define STATUS_OUTPUT_GPIO_Port GPIOB
#define SC_CHARGE_EN_Pin GPIO_PIN_2
#define SC_CHARGE_EN_GPIO_Port GPIOB
#define INPUT_LED_Pin GPIO_PIN_12
#define INPUT_LED_GPIO_Port GPIOB
#define SC_LED_Pin GPIO_PIN_13
#define SC_LED_GPIO_Port GPIOB
#define SC_OUTPUT_EN_Pin GPIO_PIN_14
#define SC_OUTPUT_EN_GPIO_Port GPIOB
#define BTN3_Pin GPIO_PIN_15
#define BTN3_GPIO_Port GPIOA
#define BTN2_Pin GPIO_PIN_4
#define BTN2_GPIO_Port GPIOB
#define BTN1_Pin GPIO_PIN_5
#define BTN1_GPIO_Port GPIOB
#define BEEP_Pin GPIO_PIN_8
#define BEEP_GPIO_Port GPIOB
#define CTRL_DC_INPUT_Pin GPIO_PIN_9
#define CTRL_DC_INPUT_GPIO_Port GPIOB
